limolin234/fan_controller_v1/学习笔记.md

# 学习笔记

## 基本元器件的理解  

1. 大电容寄生电感大不利于高频滤波 故需多种大小的电容配合实现多频段滤波 好像耦合关系还很复杂
可以考虑串电阻增加不同频段效果的一致性 模电黑魔法
2. 无他,查Datasheet  

## PCB设计规范总结  

1. 信号走线3W原则 尽量少走过孔  
2. 大电流线路专门加粗  
3. 减小大电流高频回路面积  
4. 尽量使用标准元件  
5. 功率器件采用散热过孔 铺铜等措施  
6. 合理进行3D布局以便焊接  

## 工具使用心得

1. 嘉立创的封装要检查  
2. md[^1]真好用  
3. ai和在线自动设计太好用了你知道吗  

## 心得

1. 单片机用通用的 资料多是好的 手动移植麻烦  
2. 单片自带的外设也可能出问题 考虑手动配置GPIO  

[^1]:指MarkDown
