limolin234/fan_controller_v1/pictures/IMG_20251201_182052.jpg

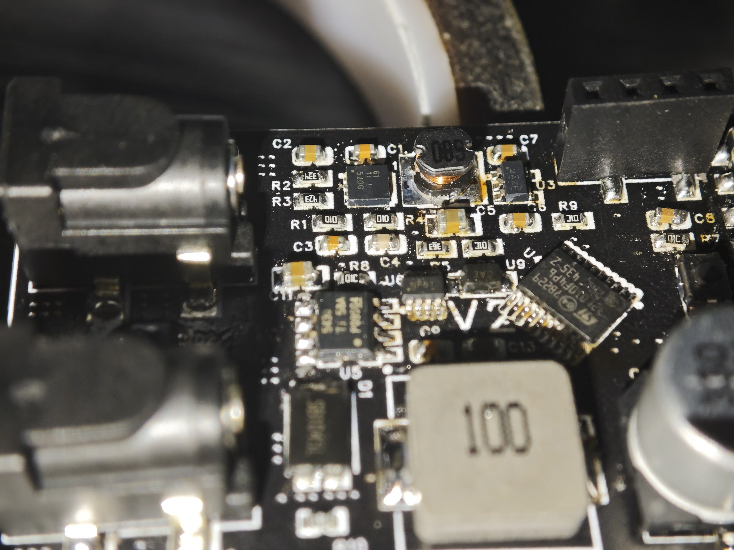
pictures/IMG_20251201_182052.jpg
