limolin234/fan_controller_v1/设计文件/pcb截图.png

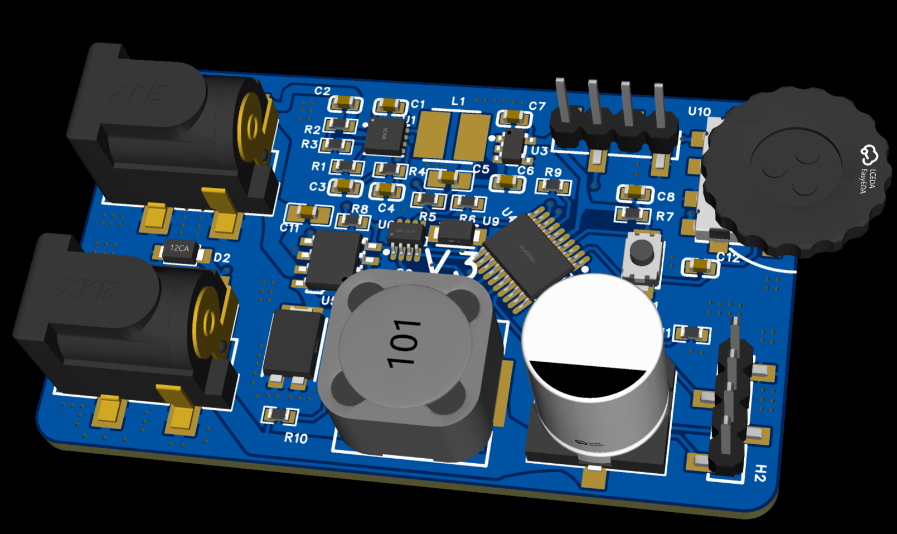
设计文件/pcb截图.png
