limolin234/fan_controller_v1/设计文件/SCH_Schematic1_2025-12-10.pdf

# 3.3V供电

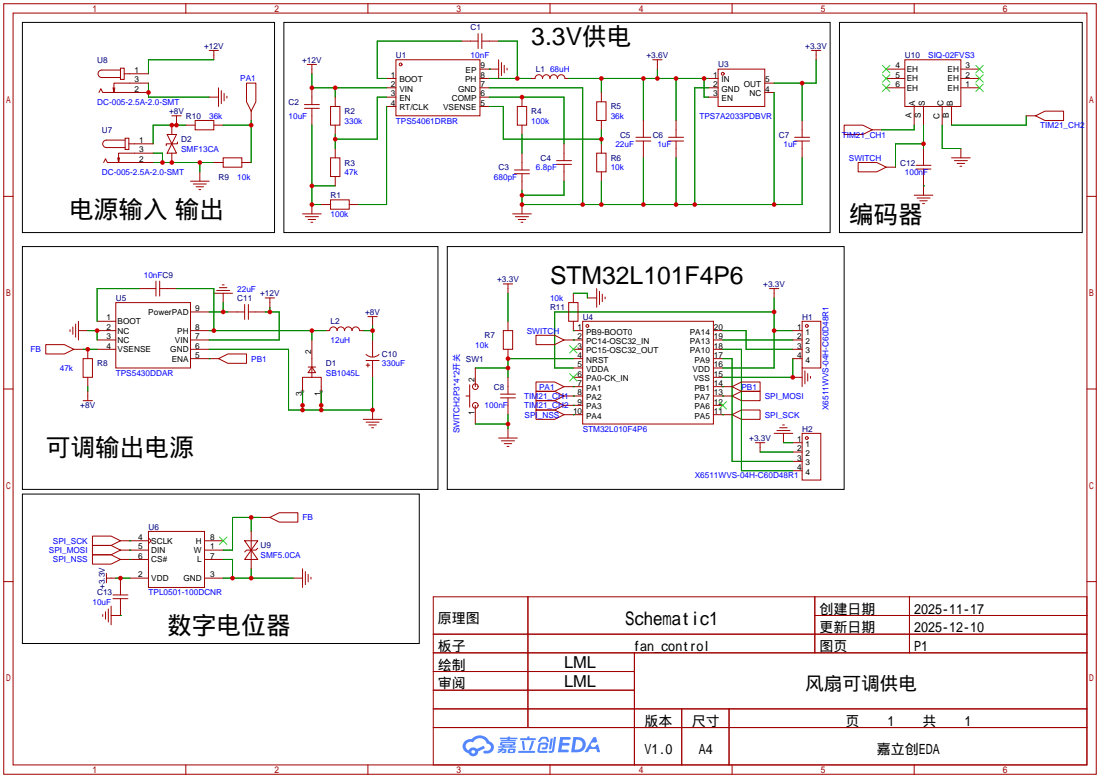
[picture p12: page 1]

原理图 | Schematic1 | 创建日期 | 2025-11-17

更新日期 | 2025-12-10

板子 | fan_control | 图页 | P1
绘制 | LML | 风扇可调供电
审阅 | LML

V1.0 | A4 | 嘉立创EDA
