limolin234/fan_controller_v1/(list of files, drawings)

Other design files:
设计文件/ProPrj_风扇可调供电_2026-04-10.epro
