limolin234/fan_controller_v1/program/Core/Src/main.c

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
/* Includes ------------------------------------------------------------------*/
#include "main.h"
#include "adc.h"
#include "i2c.h"
#include "iwdg.h"
#include "spi.h"
#include "tim.h"
#include "gpio.h"

/* USER CODE BEGIN Includes */
#include <stdbool.h>
#include "oled.h"
#include "wheel.h"
#include "resistor_calculate.h"
/* USER CODE END Includes */

/* USER CODE BEGIN PD */
void show_volt(void);
void show_power_off(void);
void power_handler(void);
void spi_transmit(void);
void resistor_calculate(void);
/* USER CODE END PD */


/* USER CODE BEGIN PV */
int volt=0;
uint8_t data=255;
volatile bool oled_switch=0;
/* USER CODE END PV */

void SystemClock_Config(void);
/**
  * @brief  The application entry point.
  * @retval int
  */
int main(void)
{

  /* MCU Configuration--------------------------------------------------------*/

  /* Reset of all peripherals, Initializes the Flash interface and the Systick. */
  HAL_Init();

  /* Configure the system clock */
  SystemClock_Config();

  /* Initialize all configured peripherals */
  MX_GPIO_Init();
  MX_I2C1_Init();
  MX_SPI1_Init();
  MX_ADC_Init();
  MX_TIM21_Init();
  MX_TIM2_Init();
  MX_IWDG_Init();
  /* USER CODE BEGIN 2 */
    HAL_GPIO_WritePin(GPIOB,GPIO_PIN_1,GPIO_PIN_RESET);
	HAL_TIM_Encoder_Start(&htim21,TIM_CHANNEL_ALL);
	OLED_Init();
	OLED_Clear();
	OLED_WriteCmd(0xAE); 
	wheel_init();
  /* USER CODE END 2 */

  /* Infinite loop */
  /* USER CODE BEGIN WHILE */
  while (1)
  {
    /* USER CODE END WHILE */

    /* USER CODE BEGIN 3 */
	  	power_handler();
	  	wheel_update();
		resistor_calculate();
		spi_transmit();
	  	show_volt();
		HAL_IWDG_Refresh (&hiwdg);
  }
  /* USER CODE END 3 */
}

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
/* USER CODE BEGIN 4 */
void spi_transmit(){
	static uint8_t last_data=0;
	if(data==last_data) return;
	last_data=data;
	HAL_GPIO_WritePin (GPIOA,GPIO_PIN_4,GPIO_PIN_RESET);
	HAL_SPI_Transmit(&hspi1,&last_data,1,50);
	HAL_GPIO_WritePin (GPIOA,GPIO_PIN_4,GPIO_PIN_SET);
}
void show_volt(void){
	if(oled_switch==0)return;
	OLED_ShowNum32(0,(volt/1000)%10);
	OLED_ShowNum32(16,(volt/100)%10);
	OLED_ShowNum32(40,(volt/10)%10);
	OLED_ShowNum32(56,volt%10);
}
void show_power_off(){
	OLED_PutChar(80,'O');
	OLED_PutChar(96,'F');
	OLED_PutChar(112,'F');
}
void power_handler(){
	static bool turned_off=1;
	static bool turned_on=0;
	static bool output_enabled=0;
	static bool output_disabled=0;
	if(oled_switch==0&&turned_off==0){
		GPIOA->PUPDR =
			(GPIOA->PUPDR & ~(GPIO_PUPDR_PUPD2_Msk | GPIO_PUPDR_PUPD3_Msk)) |
               (GPIO_PULLDOWN << 4) |  // PA2偏移：2×2=4
               (GPIO_PULLDOWN << 6); // PA3偏移：3×2=6
		HAL_TIM_Base_Stop_IT(&htim2);
		__HAL_TIM_SET_COUNTER(&htim2,0);
		OLED_WriteCmd(0xAE); 
		turned_off=1;
		turned_on=0;
	}
	if(oled_switch==1&&turned_on==0){
		GPIOA->PUPDR =
			(GPIOA->PUPDR & ~(GPIO_PUPDR_PUPD2_Msk | GPIO_PUPDR_PUPD3_Msk)) |
               (GPIO_PULLUP << 4) |  // PA2偏移：2×2=4
               (GPIO_PULLUP << 6); // PA3偏移：3×2=6
		HAL_TIM_Base_Start_IT(&htim2);
		OLED_WriteCmd(0xAF); 
		turned_off=0;
		turned_on=1;
	}
	if(volt<200&&output_disabled==0){
		output_disabled=1;
		output_enabled=0;
		OLED_Clear();
		OLED_ShowDot(3,33);
		show_power_off();
		HAL_GPIO_WritePin(GPIOB,GPIO_PIN_1,GPIO_PIN_RESET);
	}
	if(volt>=200&&output_enabled==0){
		output_disabled=0;
		output_enabled=1;
		OLED_Clear();
		OLED_PutChar(72,'V');
		OLED_ShowDot(3,33);
		HAL_GPIO_WritePin(GPIOB,GPIO_PIN_1,GPIO_PIN_SET);
	}
}
void HAL_GPIO_EXTI_Callback(uint16_t GPIO_Pin)
{
	static uint32_t last_interrupt_time = 0;
	uint32_t current_time = HAL_GetTick();
	if(current_time - last_interrupt_time < 50
		&&current_time - last_interrupt_time >10000) return;
    last_interrupt_time = current_time;
	
	if(GPIO_Pin == SWITCH_Pin)
	{
		oled_switch=!oled_switch;
	}
}
void HAL_TIM_PeriodElapsedCallback(TIM_HandleTypeDef *htim){
	oled_switch=0;
	HAL_TIM_Base_Stop(&htim2);
	__HAL_TIM_SET_COUNTER(&htim2,0);
}
/* USER CODE END 4 */
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
