limolin234/fan_controller_v1/program/Core/Inc/main.h

#define SWITCH_Pin GPIO_PIN_14
#define SWITCH_GPIO_Port GPIOC
#define SWITCH_EXTI_IRQn EXTI4_15_IRQn
#define NSS_Pin GPIO_PIN_4
#define NSS_GPIO_Port GPIOA
#define POWER_Pin GPIO_PIN_1
#define POWER_GPIO_Port GPIOB
