limolin234/fan_controller_v1/(commit log)

2025-12-11 Update and rename 实践报告.md to README.md
2025-12-14 重新整理代码
2025-12-14 减小体积
    [ProPrj_风扇可调供电_2025-12-10.epro]
2025-12-14 把文件加回来了
    [ProPrj_风扇可调供电_2025-12-10.epro]
2025-12-14 减少了可生成文件 节约空间
2025-12-14 删除了整个Drivers文件夹 mx可以生成
2025-12-15 修复了PB1 复位位置错误
2025-12-16 添加了ppt
2026-04-10 合并了地平面 提供更好的接地
    [ProPrj_风扇可调供电_2025-12-10.epro, ProPrj_风扇可调供电_2026-04-10.epro]
