limolin234/fan_controller_v1/(notices)

Notices in the files:
program/Core/Src/main.c:
Copyright (c) 2025 STMicroelectronics.
All rights reserved.
This software is licensed under terms that can be found in the LICENSE file
